kylehammer118/ME405-Pen-Plotter-Project/(list of files, cad)

Other CAD files:
Pulley_T-MXL-XL-HTD-GT2_N-tooth.scad
Arm Base Attachment v4.f3d
Arm Part v1.f3d
Elbow v2.f3d
Flange v3 v5.f3d
Pen Fixture - Bottom v5.f3d
