kylehammer118/ME405-Pen-Plotter-Project/(commit log)

2022-06-05 Add files via upload
    Testing
    [Pen Fixture - Bottom v5.f3d, Pulley_T-MXL-XL-HTD-GT2_N-tooth.scad]
2022-06-05 Add files via upload
    Fusion Files Upload
    [Arm Base Attachment v4.f3d, Arm Part v1.f3d, Elbow v2.f3d, Flange v3 v5.f3d]
